klauscam/Arduino-Lightning-Detector/(threads)

Thread 3 (2021-08-09):

'ADCSRA' was not declared in this scope

sweetlou4, 2021-08-09:
So to be clear, it will not work with STM32?

`Arduino: 1.8.15 (Windows 10), "Generic STM32F1 series, Generic F103C8Tx, STM32CubeProgrammer (SWD), Enabled (generic 'Serial'), None, Low/Full Speed, Smallest (-Os default), Newlib Nano (default)"

In file included from C:\Users\Temp\AppData\Local\Arduino15\packages\STMicroelectronics\hardware\stm32\2.0.0\cores\arduino/wiring.h:34,

                 from C:\Users\Temp\AppData\Local\Arduino15\packages\STMicroelectronics\hardware\stm32\2.0.0\cores\arduino/Arduino.h:36,

                 from sketch\sketch_aug09a.ino.cpp:1:

C:\Users\Temp\Documents\Arduino\sketch_aug09a\sketch_aug09a.ino: In function 'void setup()':

sketch_aug09a:26:6: error: 'ADCSRA' was not declared in this scope

   26 |  sbi(ADCSRA,ADPS2) ;

      |      ^~~~~~

C:\Users\Temp\AppData\Local\Arduino15\packages\STMicroelectronics\hardware\stm32\2.0.0\cores\arduino/wiring_constants.h:105:30: note: in definition of macro 'sbi'

  105 |   #define sbi(reg, bitmask) *reg |= bitmask

      |                              ^~~

sketch_aug09a:26:13: error: 'ADPS2' was not declared in this scope

   26 |  sbi(ADCSRA,ADPS2) ;

      |             ^~~~~

C:\Users\Temp\AppData\Local\Arduino15\packages\STMicroelectronics\hardware\stm32\2.0.0\cores\arduino/wiring_constants.h:105:37: note: in definition of macro 'sbi'

  105 |   #define sbi(reg, bitmask) *reg |= bitmask

      |                                     ^~~~~~~

sketch_aug09a:27:13: error: 'ADPS1' was not declared in this scope

   27 |  cbi(ADCSRA,ADPS1) ;

      |             ^~~~~

C:\Users\Temp\AppData\Local\Arduino15\packages\STMicroelectronics\hardware\stm32\2.0.0\cores\arduino/wiring_constants.h:102:38: note: in definition of macro 'cbi'

  102 |   #define cbi(reg, bitmask) *reg &= ~bitmask

      |                                      ^~~~~~~

sketch_aug09a:28:13: error: 'ADPS0' was not declared in this scope

   28 |  cbi(ADCSRA,ADPS0) ;

      |             ^~~~~

C:\Users\Temp\AppData\Local\Arduino15\packages\STMicroelectronics\hardware\stm32\2.0.0\cores\arduino/wiring_constants.h:102:38: note: in definition of macro 'cbi'

  102 |   #define cbi(reg, bitmask) *reg &= ~bitmask

      |                                      ^~~~~~~

exit status 1

'ADCSRA' was not declared in this scope
`
